mircomunch/GREATER-PV-Tracer/wiki/References.md

# References

[Description](https://github.com/mircomunch/GREATER-PV-Tracer/wiki/Description) | [Items](https://github.com/mircomunch/GREATER-PV-Tracer/wiki/Items) | [Tutorial](https://github.com/mircomunch/GREATER-PV-Tracer/wiki/Tutorial)

## Datasheet

##### [1]
<https://docs.espressif.com/projects/esp-dev-kits/en/latest/esp32c6/esp32-c6-devkitc-1/index.html>
