mircomunch/GREATER-PV-Tracer/3d_box/logo_scritta.stl

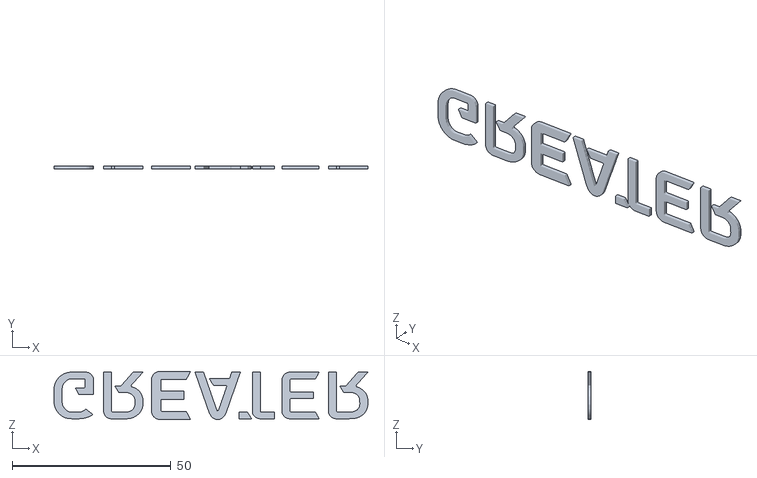
[picture p12: CAD file, 2026-10-28]
3d_box/logo_scritta.stl
98.9 x 1.00 x 15.2
