mircomunch/GREATER-PV-Tracer/3d_box_ams/button_cover.step

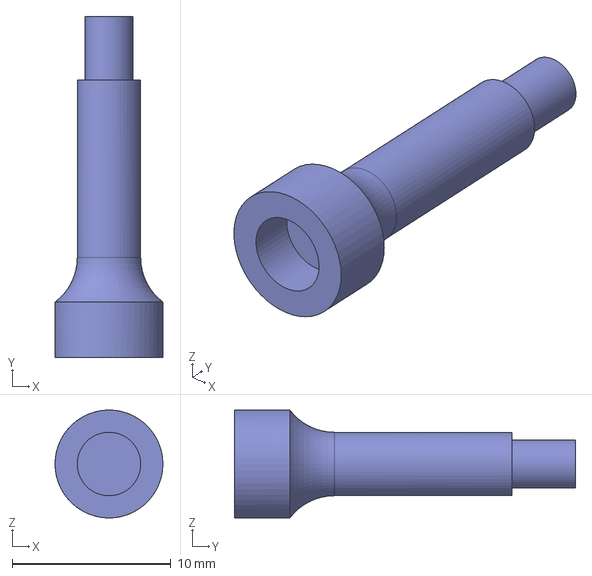
[picture p13: CAD file, 2026-10-28]
3d_box_ams/button_cover.step
6.80 x 21.5 x 6.80 mm
