mircomunch/GREATER-PV-Tracer/3d_box/box_top.stl

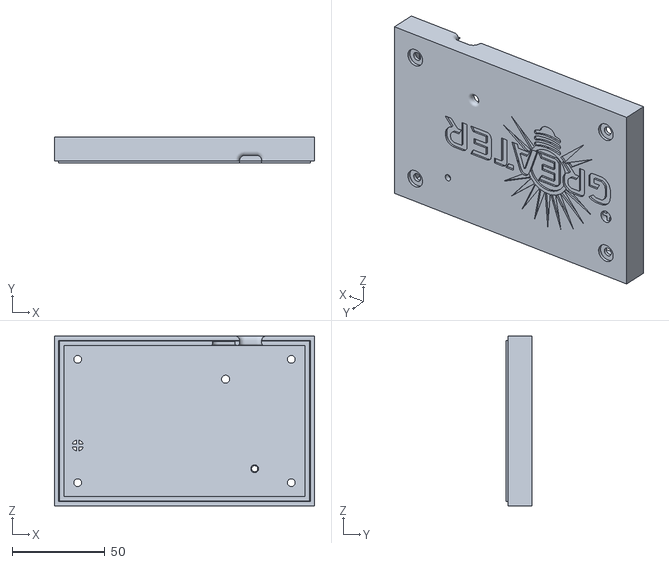
[picture p14: CAD file, 2026-10-28]
3d_box/box_top.stl
140.0 x 14.0 x 91.4
