mircomunch/GREATER-PV-Tracer/3d_box_ams/box_bottom.step

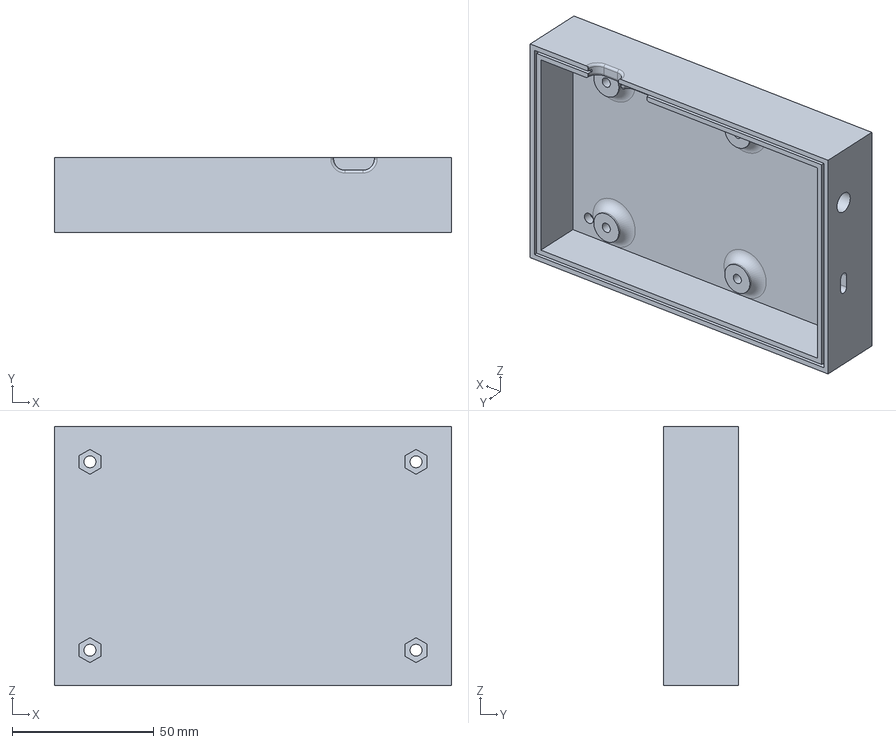
[picture p15: CAD file, 2026-10-28]
3d_box_ams/box_bottom.step
140.0 x 26.3 x 91.4 mm
