mircomunch/GREATER-PV-Tracer/3d_box/logo_lampadina.stl

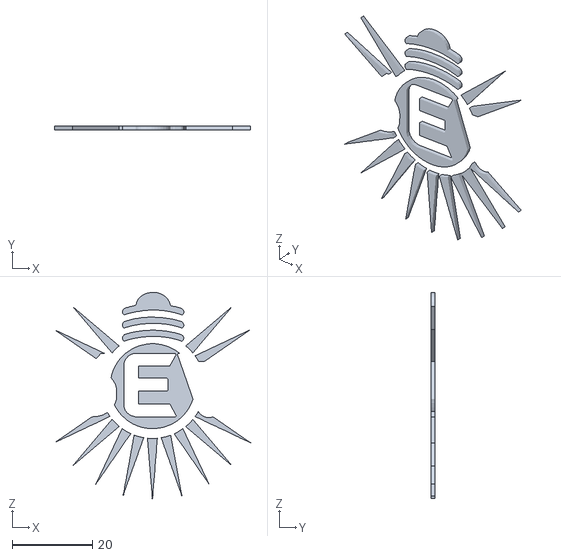
[picture p16: CAD file, 2026-10-28]
3d_box/logo_lampadina.stl
48.8 x 1.00 x 51.3
