mircomunch/GREATER-PV-Tracer/3d_box_ams/box_top_ams.step

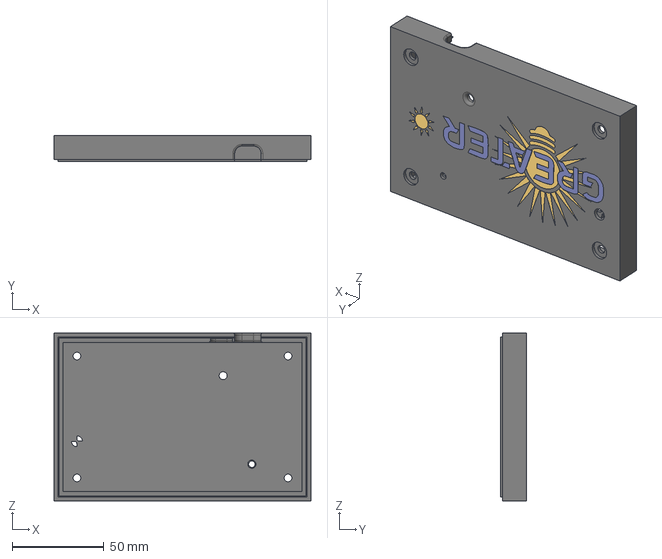
[picture p17: CAD file, 2026-10-28]
3d_box_ams/box_top_ams.step
140.0 x 14.0 x 91.4 mm
