mircomunch/GREATER-PV-Tracer/3d_box/botton_cover.stl

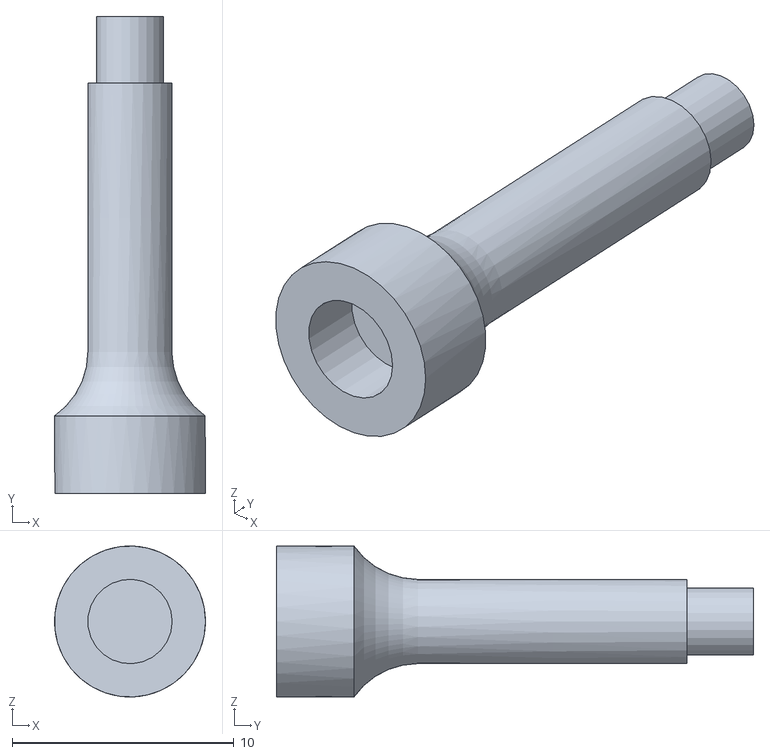
[picture p18: CAD file, 2026-10-28]
3d_box/botton_cover.stl
6.80 x 21.5 x 6.80
