mircomunch/GREATER-PV-Tracer/(list of files, cad)

Other CAD files:
3d_box/box_bottom.stl
3d_box_ams/box_top_ams.obj
