mircomunch/GREATER-PV-Tracer/wiki/Schematic_PCB_V2.pdf

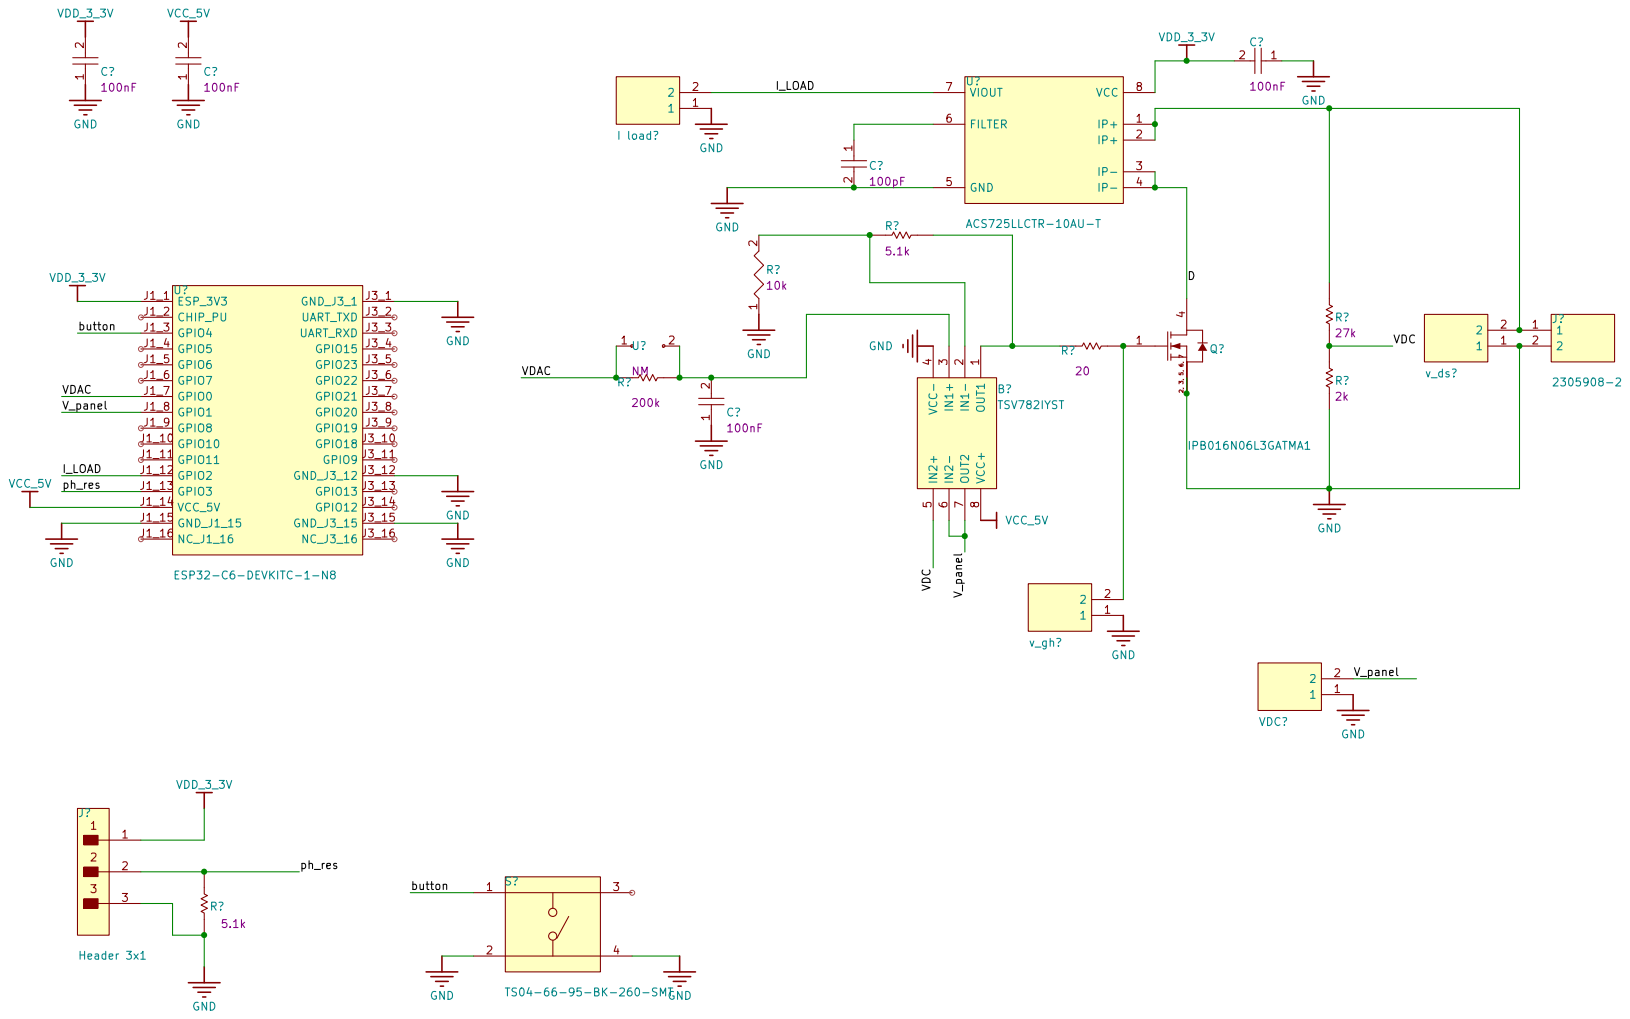
[picture p19: page 1]
